mararaw/GPS-locator/README.md

# GPS-locator
secondary school graduation thesis 2018
