mararaw/GPS-locator/(list of files, drawings)

Other design files:
Orcad/4BSYROVYM.OLB
Orcad/SYROVY4B.DSN
Orcad/SYROVY4B.opj
